goran-mahovlic/megaphone-low-current-dc-dc-converter/README.md

# High-Efficiency Low-Current DC:DC Converter Module for MEGAphone

Adapted from Byte Sized Projects for MEGAphone
Used and released under GPLv3
