goran-mahovlic/megaphone-low-current-dc-dc-converter/TPS631000DRLR.step

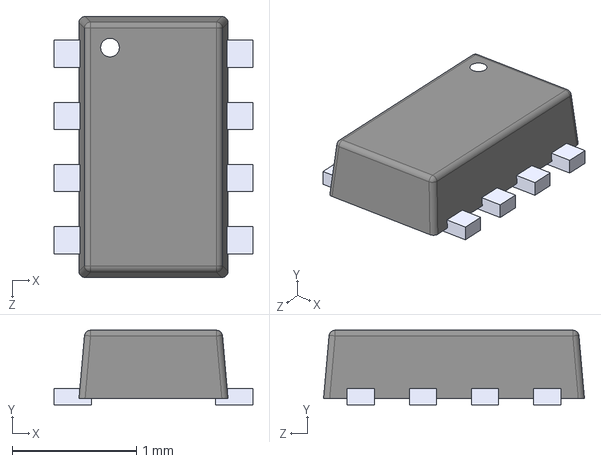
[picture p1: CAD file, 2025-02-22]
TPS631000DRLR.step
1.60 x 0.6 x 2.10 mm
