goran-mahovlic/megaphone-low-current-dc-dc-converter/megaphone-low-current-dc-dc-converter.kicad_pcb

## KiCad design megaphone-low-current-dc-dc-converter.kicad_pcb (2025-08-07)

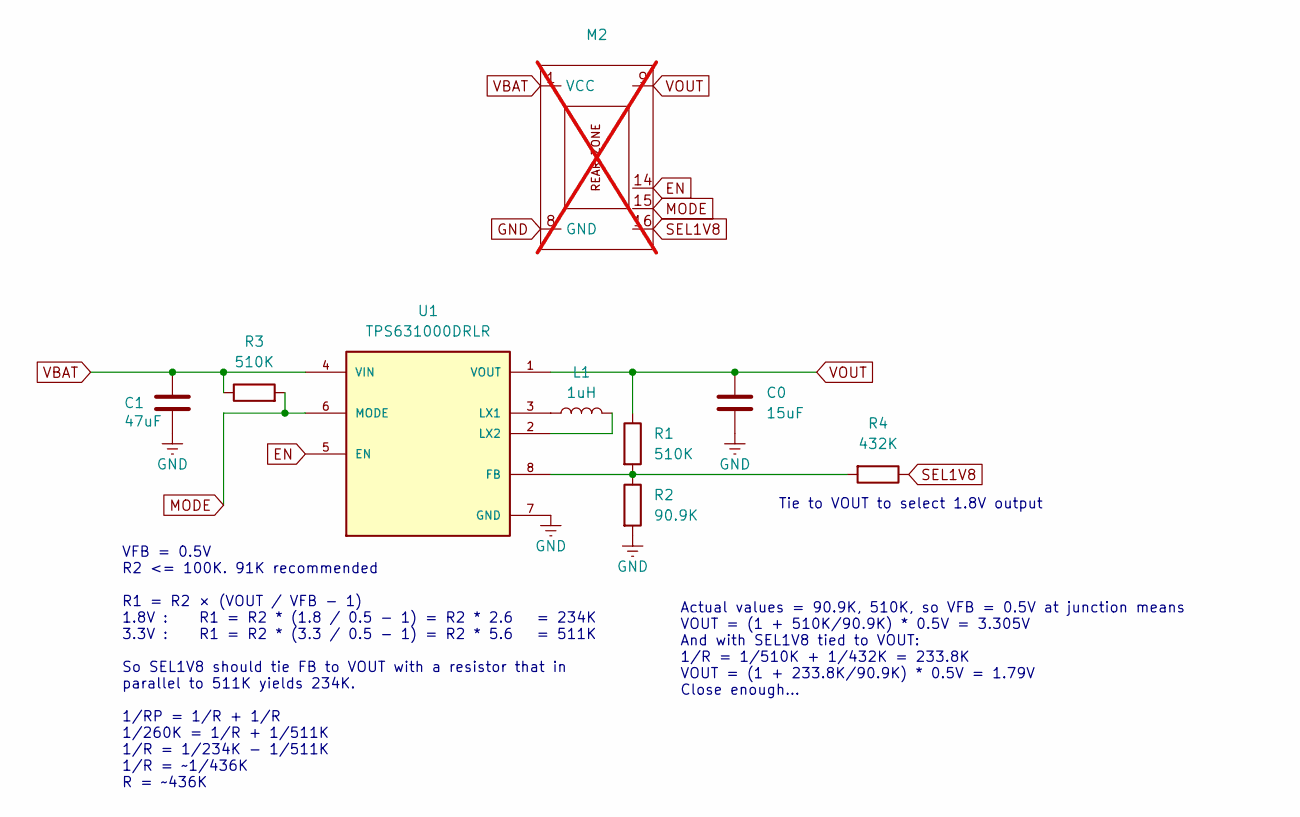
[picture p2: schematic megaphone-low-current-dc-dc-converter.kicad_sch, MEGAphone megaphone-low-current-dc-dc-converter]

Parts:
C0: 15uF; C_0805_2012Metric; LCSC C23692982
C1: 47uF; C_0805_2012Metric; LCSC C16780
L1: 1uH; L_1008_2520Metric_Pad1.43x2.20mm_HandSolder; LCSC C882955
M2: MegaCastle2x8-Module-I15.0x15.5-M8187-SPAREPAD; not fitted
R1, R3: 510K; R_0805_2012Metric; LCSC C2907332
R2: 90.9K; R_0805_2012Metric; LCSC C229044
R4: 432K; R_0805_2012Metric; LCSC C137526
U1: TPS631000DRLR; SOT50P160X60-8N; PARTREV B; LCSC C5219190

Connections:
EN: M2.14, U1.5 (EN)
GND: C0.2, C1.1, M2.8 (GND), R2.2, U1.7 (GND)
MODE: M2.15, R3.2, U1.6 (MODE)
unnamed: R1.2, R2.1, R4.2, U1.8 (FB)
unnamed: L1.1, U1.3 (LX1)
unnamed: L1.2, U1.2 (LX2)
SEL1V8: M2.16, R4.1
VBAT: C1.2, M2.1 (VCC), R3.1, U1.4 (VIN)
VOUT: C0.1, M2.9, R1.1, U1.1 (VOUT)

Notes on the sheet:
VFB = 0.5V R2 <= 100K. 91K recommended R1 = R2 × (VOUT / VFB - 1) 1.8V : R1 = R2 * (1.8 / 0.5 - 1) = R2 * 2.6 = 234K 3.3V : R1 = R2 * (3.3 / 0.5 - 1) = R2 * 5.6 = 511K So SEL1V8 should tie FB to VOUT with a resistor that in parallel to 511K yields 234K. 1/RP = 1/R + 1/R 1/260K = 1/R + 1/511K 1/R = 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
Actual values = 90.9K, 510K, so VFB = 0.5V at junction means VOUT = (1 + 510K/90.9K) * 0.5V = 3.305V And with SEL1V8 tied to VOUT: 1/R = 1/510K + 1/432K = 233.8K VOUT = (1 + 233.8K/90.9K) * 0.5V = 1.79V Close enough...
Tie to VOUT to select 1.8V output

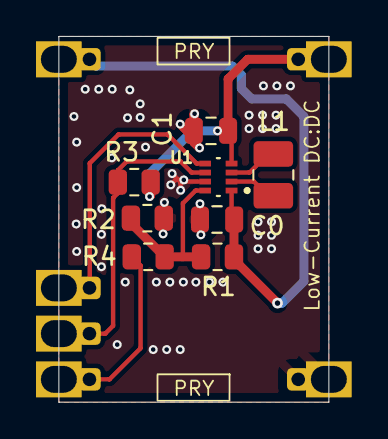
[picture p3: board megaphone-low-current-dc-dc-converter.kicad_pcb from above]

Board: 2 copper layers, 15.0 x 20.3 mm, 9 parts (1 on the bottom side), 9 nets.
