goran-mahovlic/megaphone-low-current-dc-dc-converter/(commit log)

2025-02-22 begin refactoring MPPT controller to extract just DC:DC
    [MPPT Charge Controller.kicad_pcb, MPPT Charge Controller.kicad_sch, Solder Paste Jig.3mf]
2025-02-22 rename files for new project
    [megaphone-low-current-dc-dc-converter.kicad_pcb, megaphone-low-current-dc-dc-converter.kicad_sch]
2025-02-22 change all MPPT references in files to new project name
    [megaphone-low-current-dc-dc-converter.kicad_pcb, megaphone-low-current-dc-dc-converter.kicad_sch]
2025-02-22 prune out unnecessary part of schematic
    [megaphone-low-current-dc-dc-converter.kicad_pcb, megaphone-low-current-dc-dc-converter.kicad_sch]
2025-02-22 finish adapting MPPT into simple low-current 3.3V DC:DC regulator
    [megaphone-low-current-dc-dc-converter.kicad_pcb, megaphone-low-current-dc-dc-converter.kicad_sch]
2025-02-22 add footprint, symbol and 3D model for DC:DC regulator
    [TPS631000DRLR.step]
2025-02-22 use TPS631000 DC:DC converter
    [megaphone-low-current-dc-dc-converter.kicad_pcb, megaphone-low-current-dc-dc-converter.kicad_sch]
2025-02-22 finish PCB layout
    [megaphone-low-current-dc-dc-converter.kicad_pcb, megaphone-low-current-dc-dc-converter.kicad_sch]
2025-08-05 Updating footprint, and re-routing
    [megaphone-low-current-dc-dc-converter.kicad_pcb, megaphone-low-current-dc-dc-converter.kicad_sch]
2025-08-07 Adding JLCPCB production files
    [megaphone-low-current-dc-dc-converter.kicad_pcb, megaphone-low-current-dc-dc-converter.kicad_sch]
